UAV-lab-IISc/desktop_wind_tunnel/WindTunnel-Instrumentation-System/images/Pi Dashbord .jpg

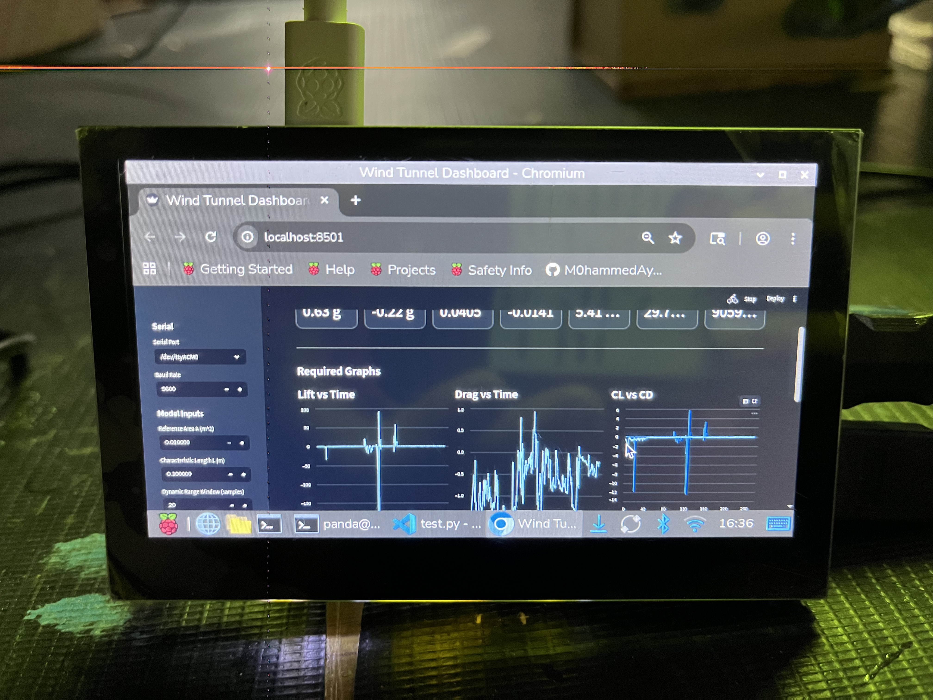
WindTunnel-Instrumentation-System/images/Pi Dashbord .jpg
