UAV-lab-IISc/desktop_wind_tunnel/README.md

Design, Fabrication and Testing of a Desktop Low-Speed 
Open-Circuit Suction-Type Wind Tunnel 

Link to Videos: https://drive.google.com/drive/folders/1i5MpmdyTTrbXydz05moX5_ehUJbkdEqA?usp=sharing
