UAV-lab-IISc/desktop_wind_tunnel/Wind tunnel Analysis of NACA 0012 Airfoil at Various AOA/wind_tunnel_output/NACA_0012_Analysis_10deg.png

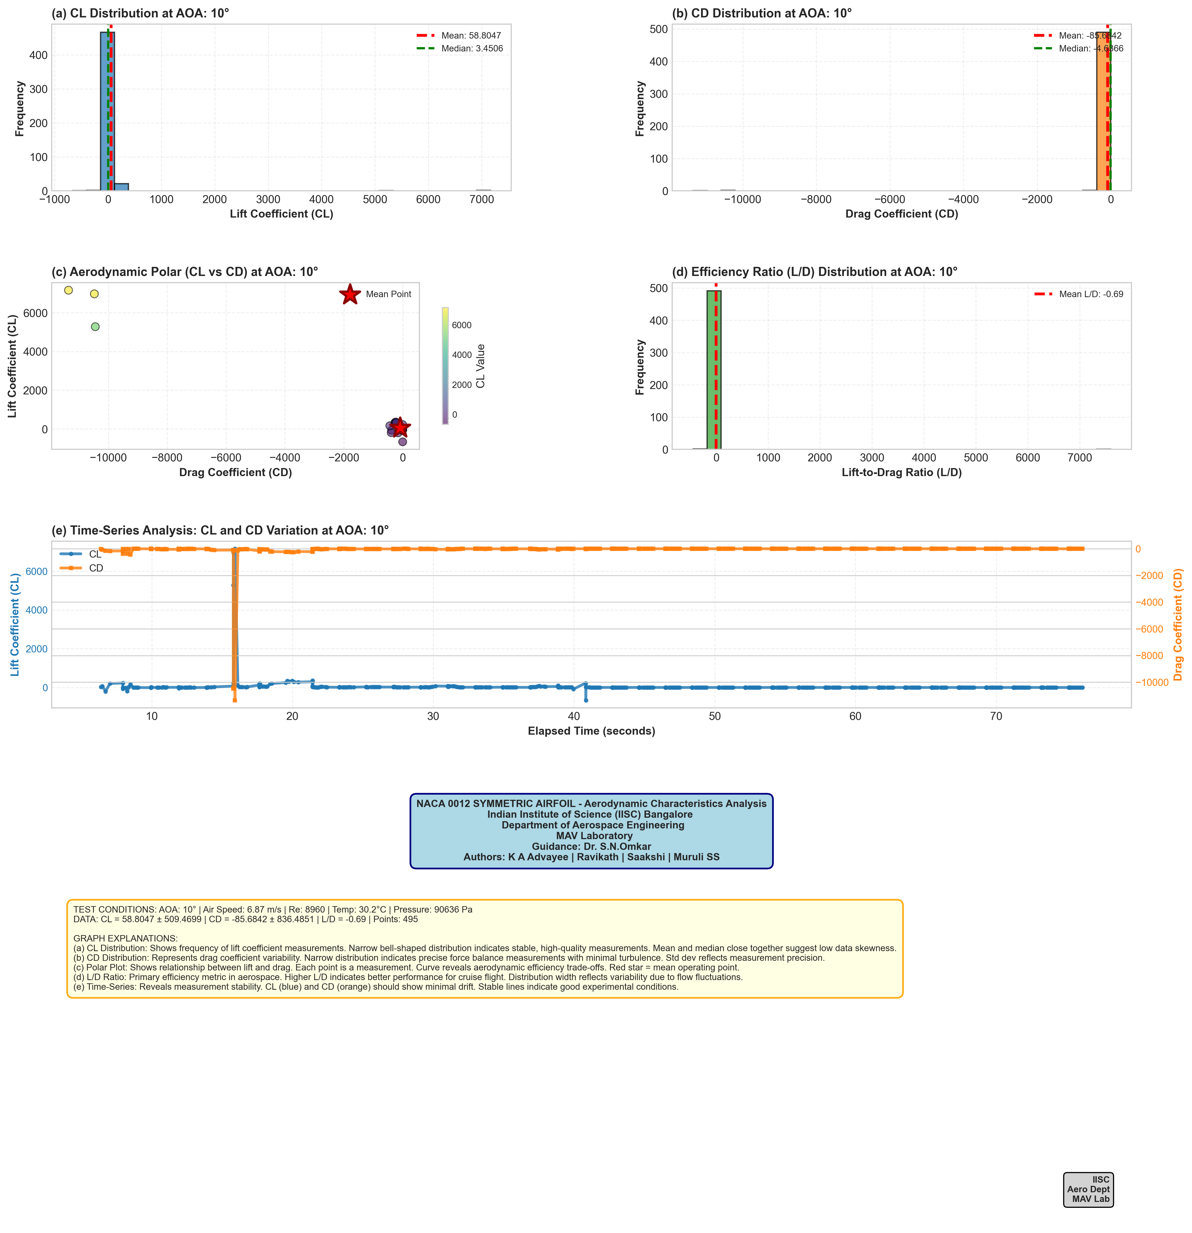
Wind tunnel Analysis of NACA 0012 Airfoil at Various AOA/wind_tunnel_output/NACA_0012_Analysis_10deg.png
