UAV-lab-IISc/desktop_wind_tunnel/WindTunnel-Instrumentation-System/chart.png

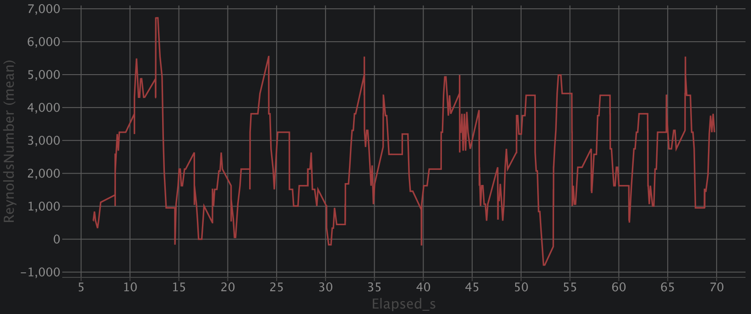
WindTunnel-Instrumentation-System/chart.png
