UAV-lab-IISc/desktop_wind_tunnel/WindTunnel-Instrumentation-System/hardware/Circuit diagram.jpg

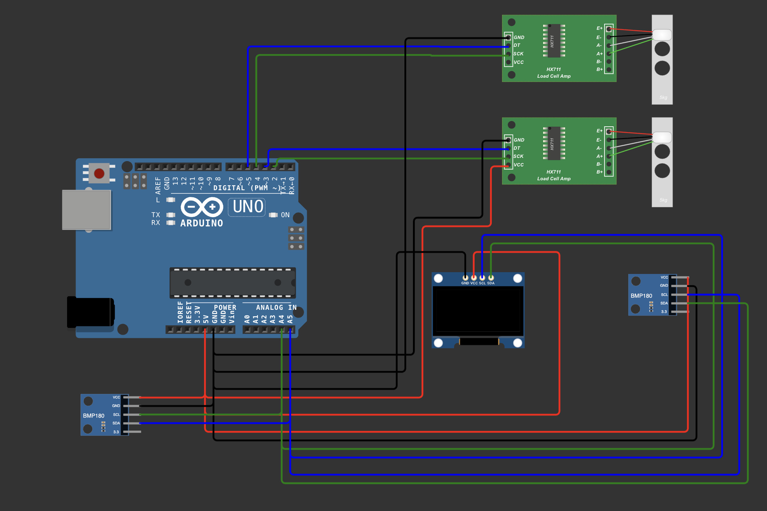
WindTunnel-Instrumentation-System/hardware/Circuit diagram.jpg
