UAV-lab-IISc/desktop_wind_tunnel/WindTunnel-Instrumentation-System/hardware/Bill of Materials.xlsx

Item | Quantuty | Reaceved | Price | LInk
HX711 Load Cell Module | 2 | Y | 39 | https://robocraze.com/products/hx711-load-cell-module?_pos=1&_sid=91b9ed3db&_ss=r
Arduino UNO R3 Transparent Plastic Case | 1 | Y | 39 | https://robocraze.com/products/transparent-plastic-case-for-arduino-uno-r3?pr_prod_strat=jac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
DHT22 Humidity and Temperature Sensor Module (AM2302) | 1 |  | 109 | https://robocraze.com/products/dht22-humidity-and-temperature-sensor-module-am2302?_pos=1&_sid=30542bb8d&_ss=r
Jumper Wire Set - M2M, M2F, F2F (40 pcs each) | 2 | Y | 124 | https://robocraze.com/products/jumper-wire-set-m2m-m2f-f2f-40-pcs-each?_pos=2&_sid=6ebbc58f2&_ss=r
0.96 Inch OLED Display Module SPI/I2C 4pin Blue Color | 1 | Y | 156 | https://robocraze.com/products/0-96in-oled-display-module-4pin
Bread Board + Power Supply | 1 | Y | 205 | https://robocraze.com/products/bread-board-power-supply?_pos=1&_sid=5c4e63501&_ss=r
BELLOX 560Pieces Heat Shrink Tubing | 1 | Y | 330 | https://www.amazon.in/BELLOX-560Pieces-Heat-Shrink-Tubing/dp/B0DZXD1YLK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
Calibration Weights, | 1 | Y | 1388 | https://www.desertcart.in/products/304083795-7-pcs-calibration-weights-scale-weight-set-1g-2g-5g
100g Load Cell | 2 | Y | 1504 | https://www.mouser.in/ProductDetail/SparkFun/SEN-14727?qs=w%2Fv1CP2dgqpUnthob2EAEQ%3D%3D
4.3inch DSI LCD Capacitive Touch Display | 1 | Y | 3399 | https://robocraze.com/products/waveshare-4-3inch-dsi-lcd-capacitive-touch-display-800-480-for-raspberry-pi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
Raspberry Pi 5 (2 GB). Optional | 1 | Y | 7519 | https://robocraze.com/products/raspberry-pi-5-model-2gb-ram?variant=46204753281248&country=IN&currency=INR
Card Board (30 CM *30 CM ) | 1 | Y
3D printed Mount | 4 | Y
Airfoil | 1 | Y
743 Glue | 1 | Y | 240 | https://www.amazon.in/743-Component-Instant-Bonding-Adhesive/dp/B0G25NWKTB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
TOTAL
