UAV-lab-IISc/desktop_wind_tunnel/WindTunnel-Instrumentation-System/3d_print/Load Cell Base.stl

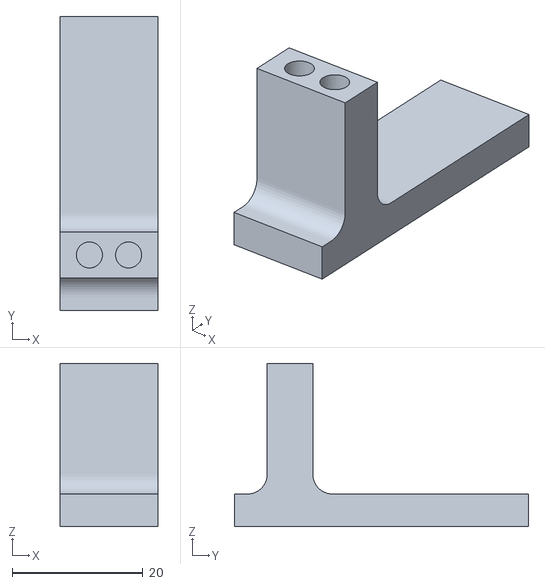
[picture p16: CAD file, 2026-05-05]
WindTunnel-Instrumentation-System/3d_print/Load Cell Base.stl
15.0 x 45.0 x 25.0
