UAV-lab-IISc/desktop_wind_tunnel/WindTunnel-Instrumentation-System/3d_print/Load Cell Attachment_.stl

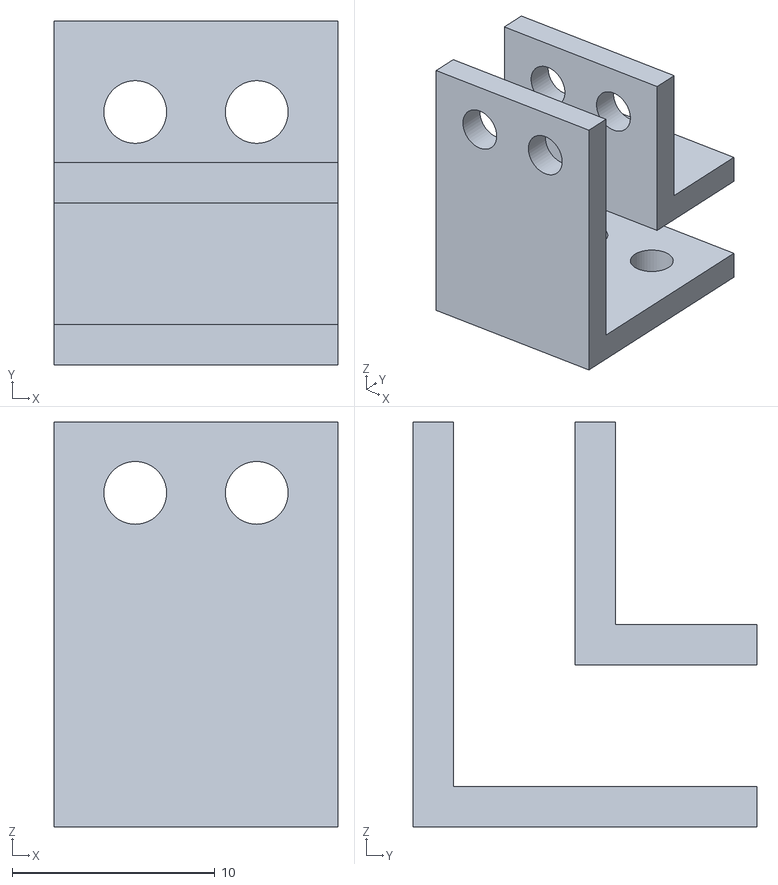
[picture p17: CAD file, 2026-05-05]
WindTunnel-Instrumentation-System/3d_print/Load Cell Attachment_.stl
14.0 x 17.0 x 20.0
