UAV-lab-IISc/desktop_wind_tunnel/WindTunnel-Instrumentation-System/3d_print/Load Cell Attachment.jpeg

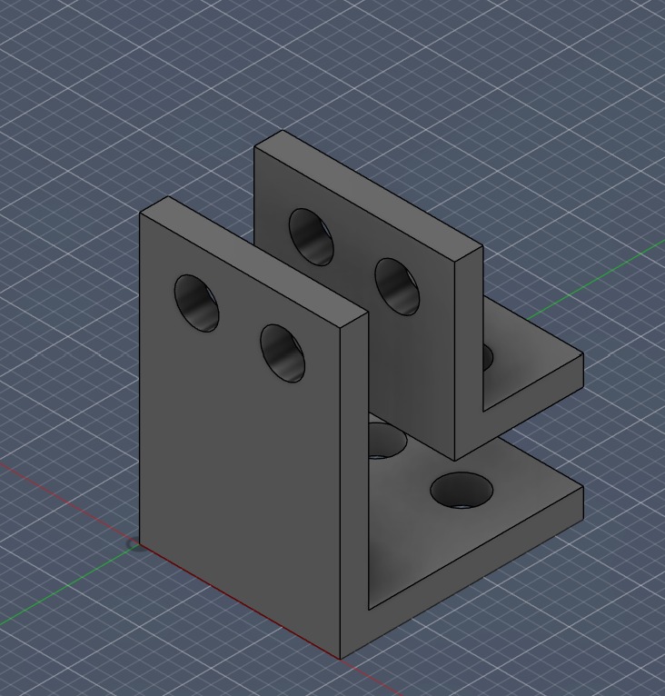
WindTunnel-Instrumentation-System/3d_print/Load Cell Attachment.jpeg
