UAV-lab-IISc/desktop_wind_tunnel/WindTunnel_Test/wind_data.csv

time | temp_c | pressure_pa | wind_mps | lift_n | drag_n | rho | q | cl | cd | re | AoA | notes
10:00:01 | 28.4 | 101325 | 12.1 | 1.18 | 0.21 | 1.18 | 86.5 | 0.98 | 0.17 | 1.45e5 | 0 | NACA0012 baseline
10:00:02 | 28.4 | 101325 | 12.2 | 1.21 | 0.22 | 1.18 | 87.9 | 1.01 | 0.18 | 1.46e5 | 0 | NACA0012 baseline
10:00:03 | 28.5 | 101320 | 12.3 | 1.26 | 0.23 | 1.18 | 89.3 | 1.05 | 0.19 | 1.47e5 | 5 | AoA sweep
10:00:04 | 28.5 | 101318 | 12.4 | 1.32 | 0.25 | 1.18 | 90.8 | 1.09 | 0.21 | 1.48e5 | 10 | AoA sweep
