UAV-lab-IISc/desktop_wind_tunnel/WindTunnel_Test/wind_tunnel_log_2026-04-14_12-14-13.csv

Timestamp | Lift_g | Drag_g | Pressure_Pa | Temperature_C | Speed_mps
2026-04-14 12:14:15 | 0.0 | -0.14 | 90976.0 | 29.6 | 0.39
2026-04-14 12:14:15 | 0.0 | -0.15 | 90976.0 | 29.7 | 0.29
2026-04-14 12:14:20 | 0.0 | -0.19 | 90977.0 | 29.6 | 0.3
2026-04-14 12:14:20 | 0.0 | -0.18 | 90974.0 | 29.6 | 0.35
2026-04-14 12:14:21 | 0.0 | -0.18 | 90972.0 | 29.6 | 0.39
2026-04-14 12:14:21 | 0.0 | -0.18 | 90974.0 | 29.6 | 0.44
2026-04-14 12:14:21 | 0.0 | -0.18 | 90975.0 | 29.6 | 0.59
2026-04-14 12:14:21 | 0.0 | -0.19 | 90978.0 | 29.6 | 0.55
2026-04-14 12:14:21 | 0.0 | -0.19 | 90974.0 | 29.6 | 0.59
2026-04-14 12:14:21 | 0.0 | -0.19 | 90975.0 | 29.6 | 0.64
2026-04-14 12:14:21 | 0.0 | -0.19 | 90973.0 | 29.6 | 0.79
2026-04-14 12:14:22 | 0.0 | -0.19 | 90971.0 | 29.6 | 0.59
2026-04-14 12:14:22 | 0.0 | -0.19 | 90978.0 | 29.6 | 0.39
2026-04-14 12:14:22 | 0.0 | -0.19 | 90973.0 | 29.6 | 0.39
2026-04-14 12:14:22 | 0.0 | -0.19 | 90976.0 | 29.6 | 0.3
2026-04-14 12:14:22 | 0.0 | -0.19 | 90973.0 | 29.6 | 0.3
2026-04-14 12:14:22 | 0.0 | -0.19 | 90980.0 | 29.6 | 0.3
2026-04-14 12:14:22 | 0.0 | -0.19 | 90979.0 | 29.6 | 0.39
2026-04-14 12:14:22 | 0.0 | -0.19 | 90977.0 | 29.6 | 0.5
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
