UAV-lab-IISc/desktop_wind_tunnel/WindTunnel_Test/wind_tunnel_log_2026-04-14_12-18-01.csv

Timestamp | Lift_g | Drag_g | Pressure_Pa | Temperature_C | Speed_mps
2026-04-14 12:18:03 | 0.0 | -0.17 | 90969.0 | 29.7 | 0.58
2026-04-14 12:18:08 | 0.0 | -0.13 | 90964.0 | 29.6 | 0.09
2026-04-14 12:18:08 | 0.0 | -0.13 | 90967.0 | 29.6 | 0.05
2026-04-14 12:18:09 | 0.0 | -0.14 | 90962.0 | 29.6 | 0.09
2026-04-14 12:18:09 | 0.0 | -0.15 | 90965.0 | 29.6 | 0.14
2026-04-14 12:18:09 | 0.0 | -0.16 | 90966.0 | 29.6 | 0.09
2026-04-14 12:18:09 | 0.0 | -0.15 | 90963.0 | 29.6 | 0.04
2026-04-14 12:18:09 | 0.0 | -0.16 | 90968.0 | 29.6 | -0.0
2026-04-14 12:18:09 | 0.0 | -0.17 | 90966.0 | 29.6 | 0.04
2026-04-14 12:18:09 | 0.0 | -0.18 | 90960.0 | 29.6 | -0.0
2026-04-14 12:18:10 | 0.0 | -0.18 | 90972.0 | 29.6 | -0.22
2026-04-14 12:18:10 | 0.0 | -0.18 | 90962.0 | 29.6 | -0.22
2026-04-14 12:18:10 | 0.0 | -0.18 | 90965.0 | 29.6 | -0.12
2026-04-14 12:18:10 | 0.0 | -0.18 | 90968.0 | 29.6 | -0.12
2026-04-14 12:18:10 | 0.0 | -0.18 | 90967.0 | 29.6 | -0.12
2026-04-14 12:18:10 | 0.0 | -0.19 | 90964.0 | 29.6 | 0.08
2026-04-14 12:18:10 | 0.0 | -0.18 | 90971.0 | 29.6 | 0.17
2026-04-14 12:18:10 | 0.0 | -0.18 | 90970.0 | 29.6 | 0.37
2026-04-14 12:18:11 | 0.0 | -0.18 | 90965.0 | 29.6 | 0.27
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
